festlv/uvfoto/README

Mechanical design files for UV photoresist exposer device.
It uses a modified laser-printer head with UV laser to expose photoresist on PCB's.
More details in latvian: http://hackerspace.lv/wiki/PCB_fotorezista_ekspon%C4%93%C5%A1ana_ar_l%C4%81zeru
