festlv/uvfoto/mechanical/assembly.SLDASM

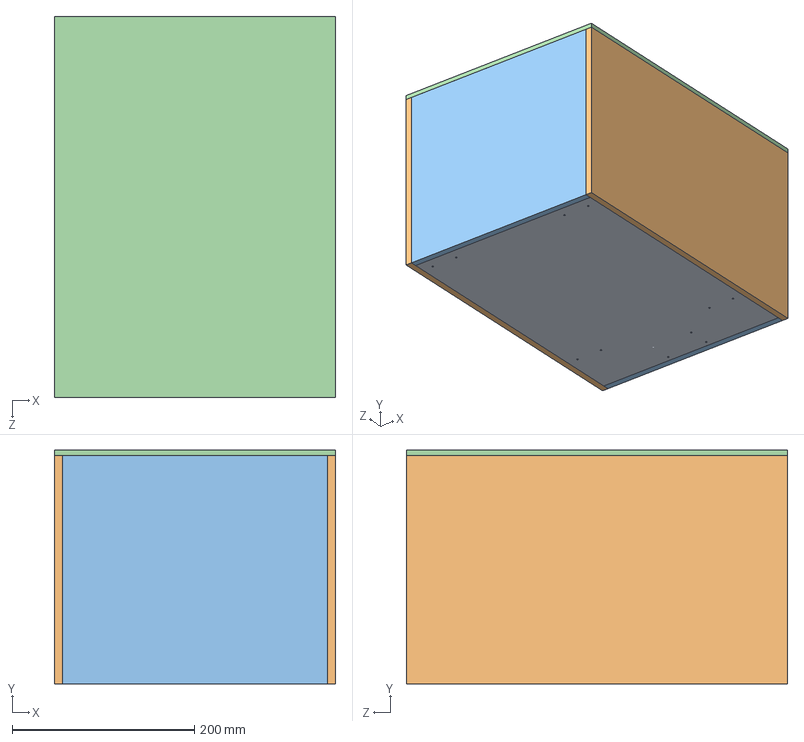
[picture p2: CAD file, 2013-05-30]
mechanical/assembly.SLDASM
308.0 x 256.0 x 418.0 mm
base
motor_mount
distancer x 4
nema_17_short
table
bar_mount x 3
bar x 2
bar_mount_switch
switch
pusher_bearing_mount x 2
lm8uul x 2
pusher_plank
pusher_mount
socket head cap screw_din x 4
slotted pan head screw_din x 11
prevailing torque nut style 1 insert_din x 4
toothed lock washer 1_din x 10
plain washer 6902 type abc_din x 9
hex nut gradec_din
carret
laserhead_base
mount
calibration x 2
mount_top
case_side x 2
case_back_side x 2
case_top
