festlv/uvfoto/mechanical/laserhead/head_assembly.SLDASM

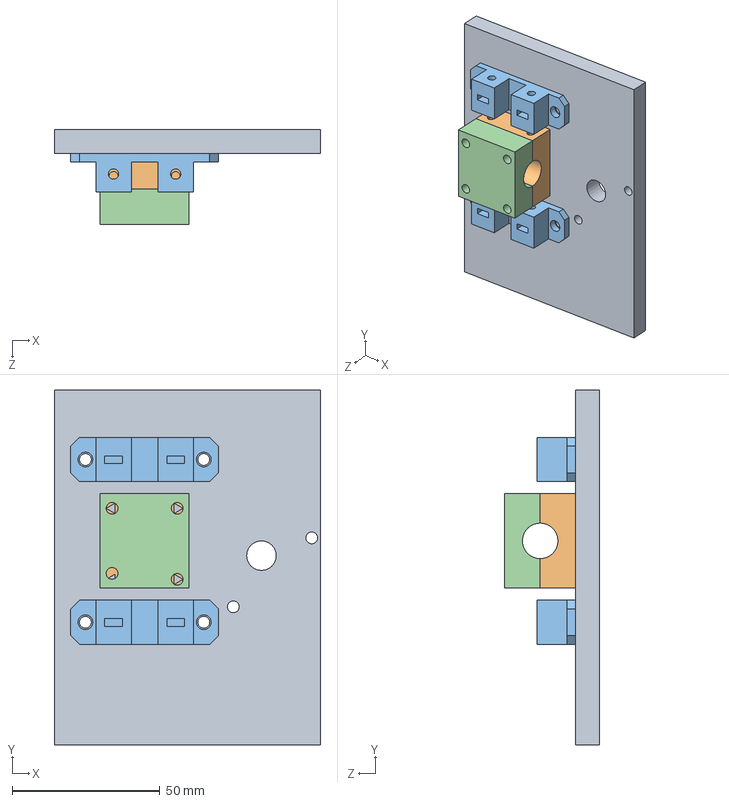
[picture p3: CAD file, 2013-05-30]
mechanical/laserhead/head_assembly.SLDASM
90.0 x 120.0 x 32.0 mm
laserhead_base
mount
calibration x 2
mount_top
