festlv/uvfoto/mechanical/bar_and_mounts.SLDASM

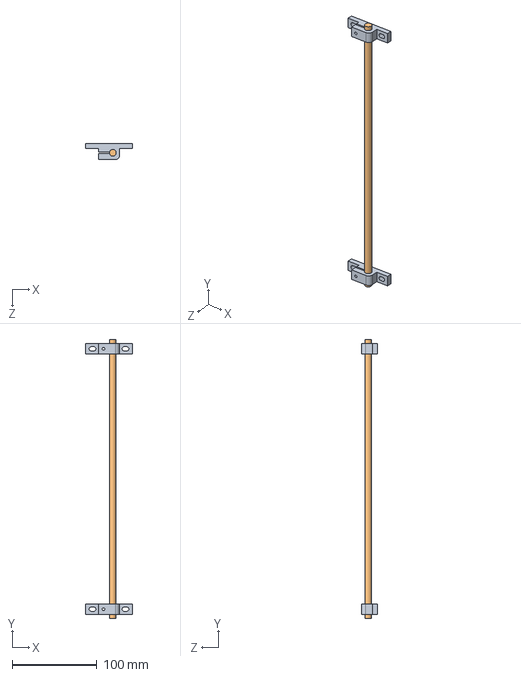
[picture p4: CAD file, 2013-04-28]
mechanical/bar_and_mounts.SLDASM
55.0 x 330.0 x 19.0 mm
bar_mount x 2
bar
