festlv/uvfoto/mechanical/bar_and_mounts_switch.SLDASM

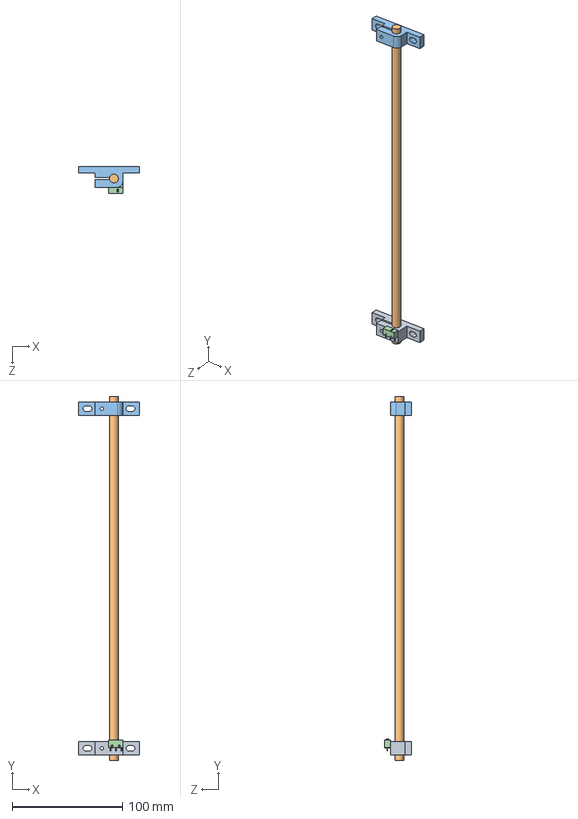
[picture p5: CAD file, 2013-04-28]
mechanical/bar_and_mounts_switch.SLDASM
55.0 x 330.0 x 24.7 mm
bar_mount_switch
bar
bar_mount
switch
