festlv/uvfoto/mechanical/motor_assy.SLDASM

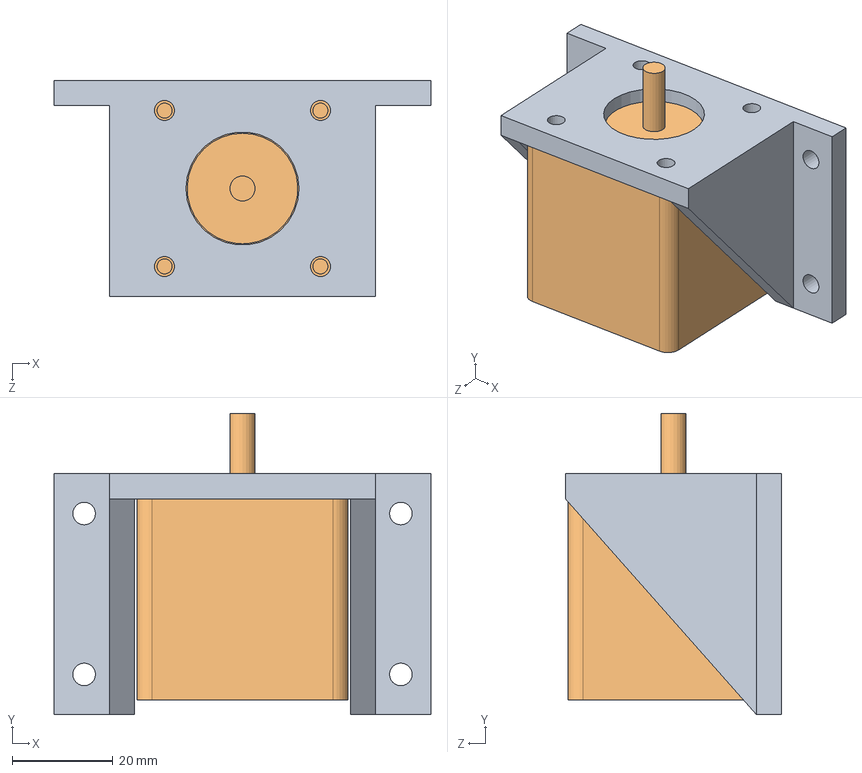
[picture p6: CAD file, 2013-03-12]
mechanical/motor_assy.SLDASM
75.0 x 59.9 x 43.0 mm
motor_mount
nema_17_short
