festlv/uvfoto/mechanical/case_top.SLDPRT

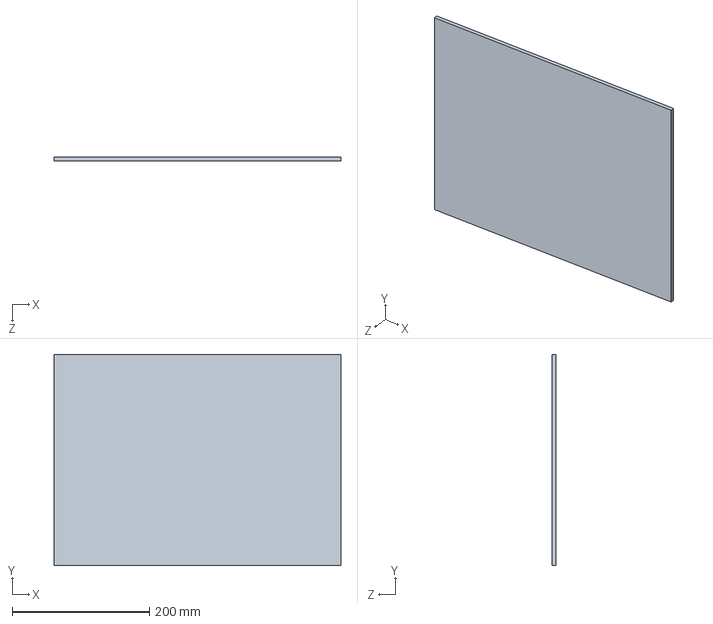
[picture p7: CAD file, 2013-05-30]
mechanical/case_top.SLDPRT
418.0 x 308.0 x 6.00 mm
