festlv/uvfoto/mechanical/laserhead/laserhead_base.SLDPRT

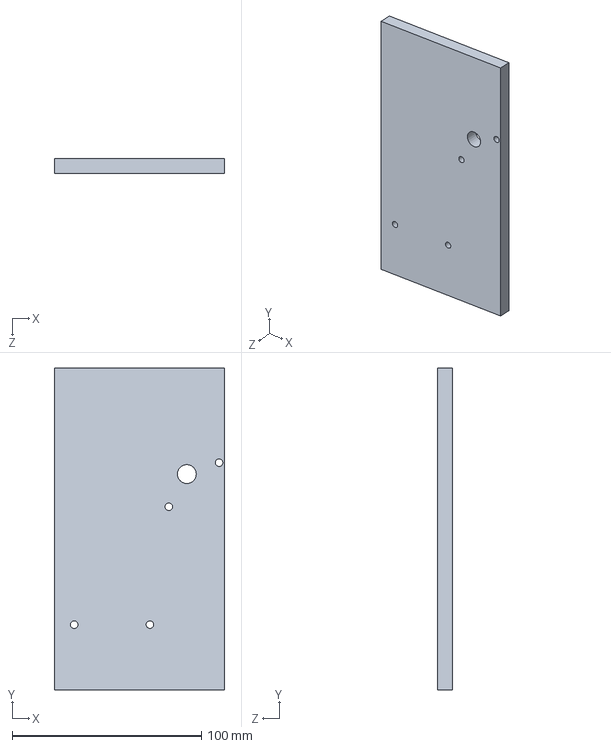
[picture p8: CAD file, 2013-05-30]
mechanical/laserhead/laserhead_base.SLDPRT
90.0 x 170.0 x 8.00 mm
