festlv/uvfoto/mechanical/stl/motor_coupling.stl

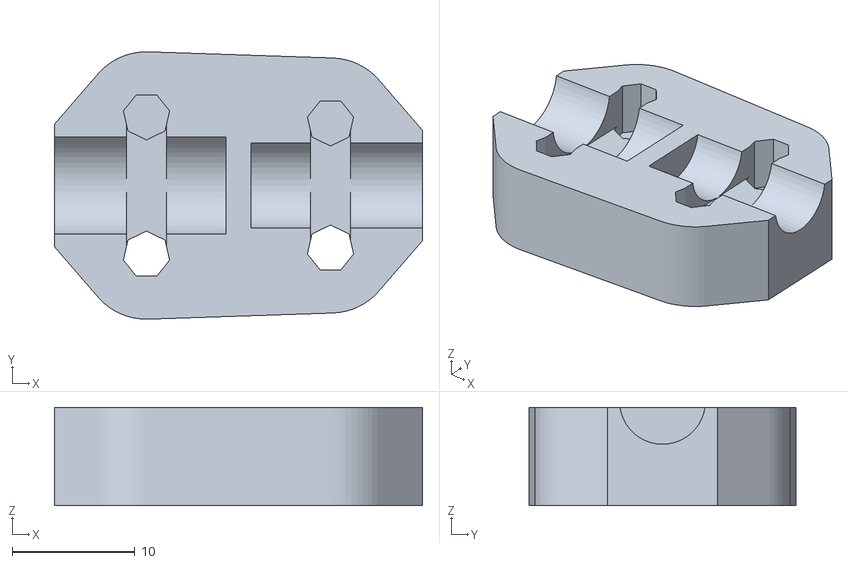
[picture p9: CAD file, 2013-04-28]
mechanical/stl/motor_coupling.stl
30.0 x 21.8 x 8.00
