festlv/uvfoto/mechanical/laserhead/mount.SLDPRT

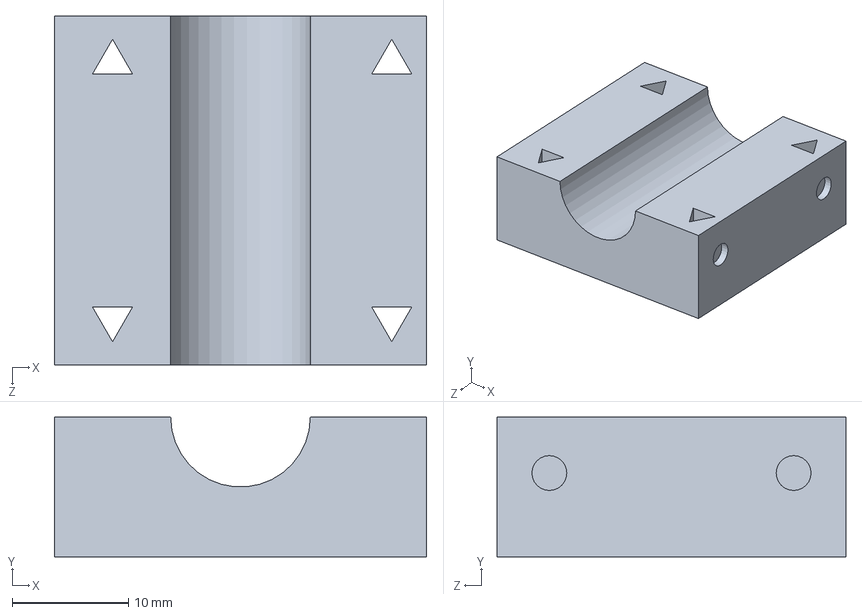
[picture p10: CAD file, 2013-05-30]
mechanical/laserhead/mount.SLDPRT
32.0 x 12.0 x 30.0 mm
