festlv/uvfoto/mechanical/stl/plate.stl

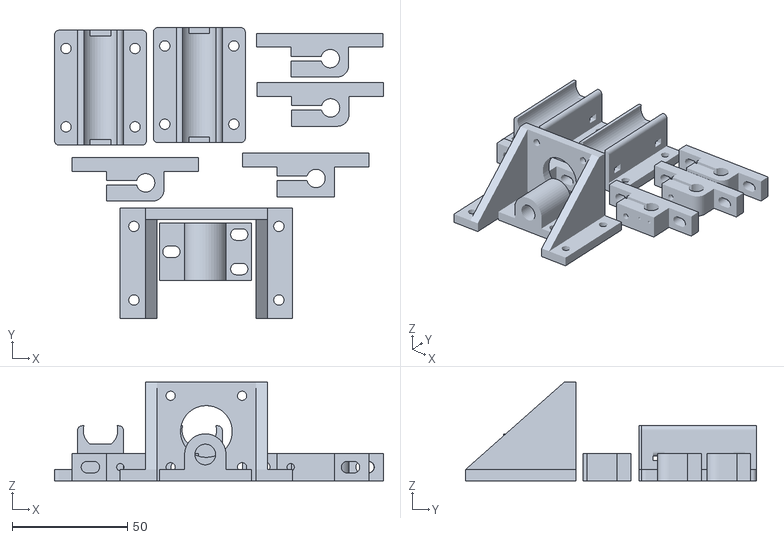
[picture p11: CAD file, 2013-04-28]
mechanical/stl/plate.stl
143.0 x 126.4 x 43.0
