festlv/uvfoto/mechanical/case_side.SLDPRT

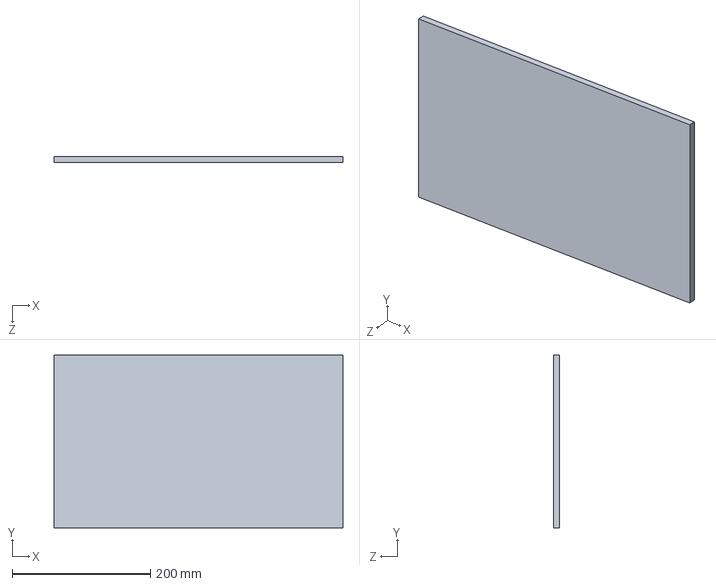
[picture p12: CAD file, 2013-05-30]
mechanical/case_side.SLDPRT
418.0 x 250.0 x 9.00 mm
