festlv/uvfoto/mechanical/laserhead/calibration.SLDPRT

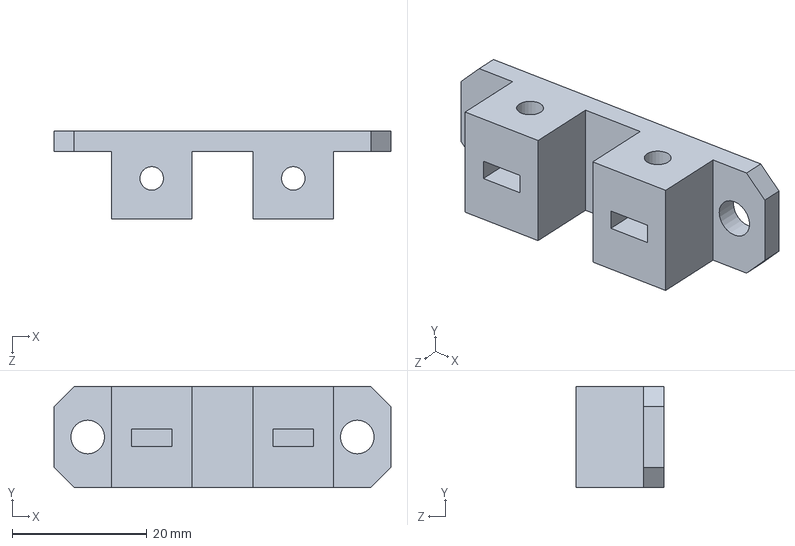
[picture p13: CAD file, 2013-05-30]
mechanical/laserhead/calibration.SLDPRT
50.0 x 15.0 x 13.0 mm
