festlv/uvfoto/mechanical/case_back_side.SLDPRT

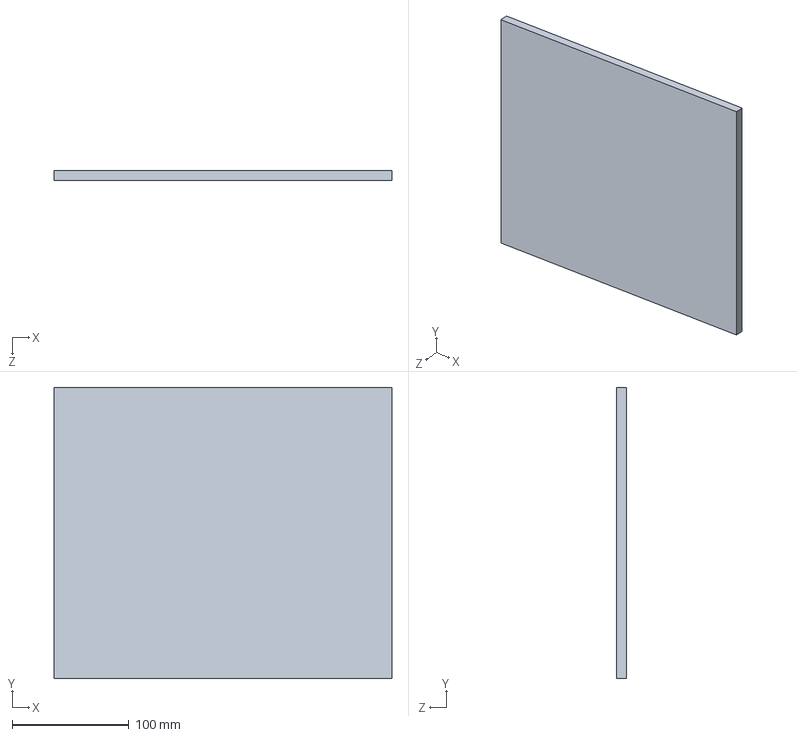
[picture p14: CAD file, 2013-05-30]
mechanical/case_back_side.SLDPRT
290.0 x 250.0 x 9.00 mm
