festlv/uvfoto/mechanical/bar_mount.SLDPRT

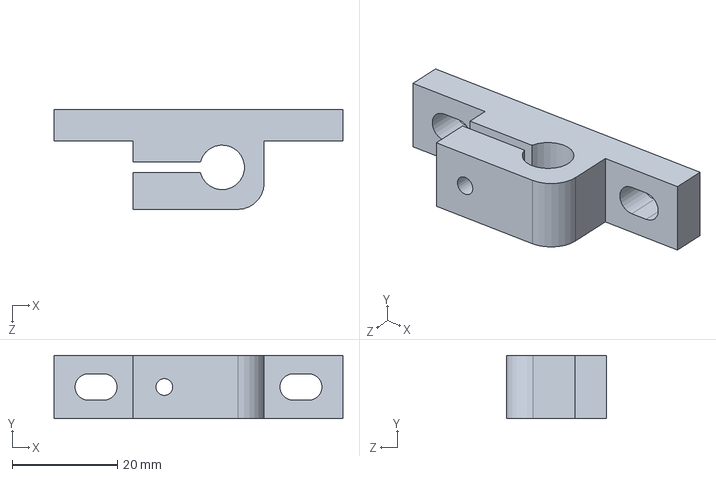
[picture p15: CAD file, 2013-04-28]
mechanical/bar_mount.SLDPRT
55.0 x 12.0 x 19.0 mm
