festlv/uvfoto/mechanical/pusher_bearing_mount.SLDPRT

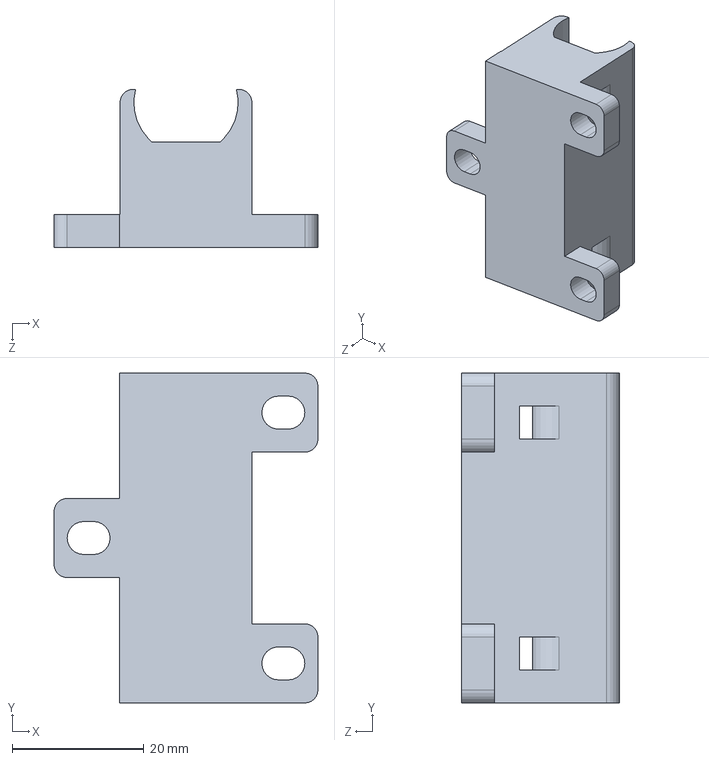
[picture p16: CAD file, 2013-04-28]
mechanical/pusher_bearing_mount.SLDPRT
40.0 x 50.0 x 24.0 mm
