festlv/uvfoto/mechanical/motor_mount.SLDPRT

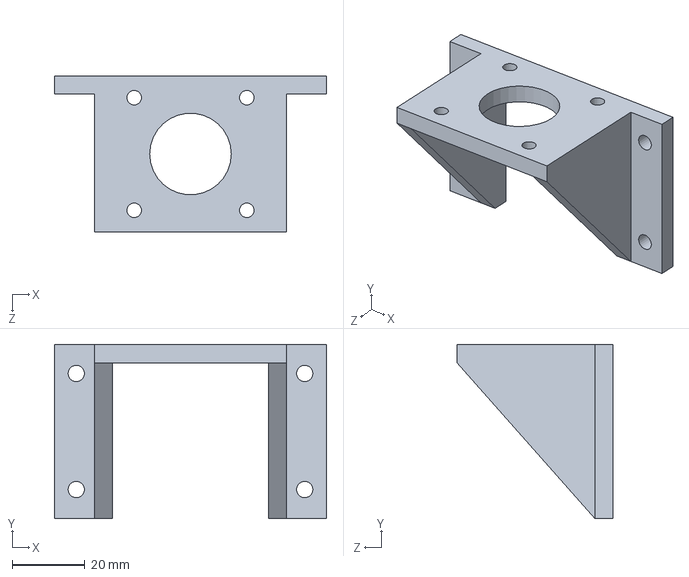
[picture p17: CAD file, 2013-04-28]
mechanical/motor_mount.SLDPRT
75.0 x 48.0 x 43.0 mm
