festlv/uvfoto/mechanical/pusher_plank.SLDPRT

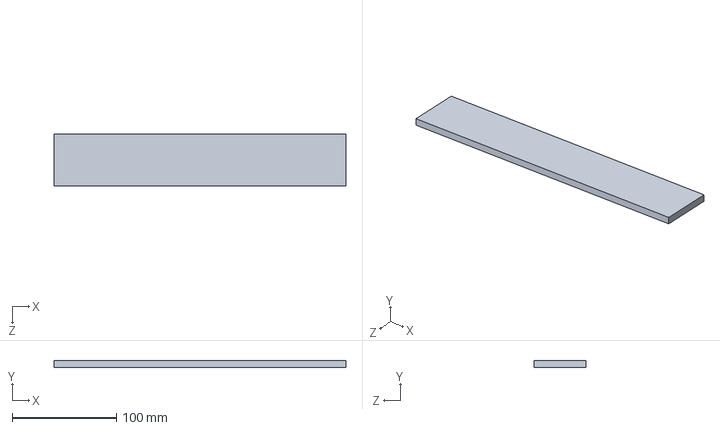
[picture p18: CAD file, 2013-04-28]
mechanical/pusher_plank.SLDPRT
280.0 x 6.50 x 50.0 mm
