festlv/uvfoto/mechanical/carret_support.SLDPRT

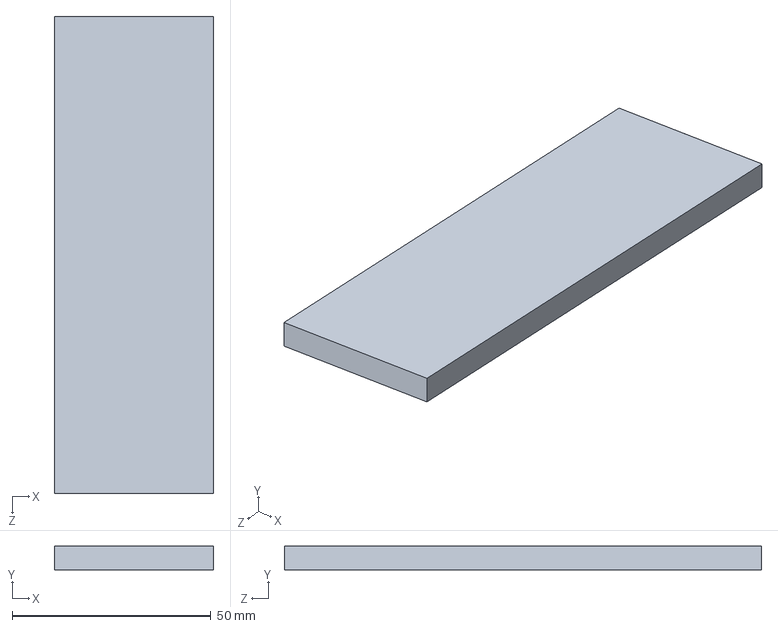
[picture p19: CAD file, 2013-03-12]
mechanical/carret_support.SLDPRT
40.0 x 6.00 x 120.0 mm
