festlv/uvfoto/mechanical/pusher_mount.SLDPRT

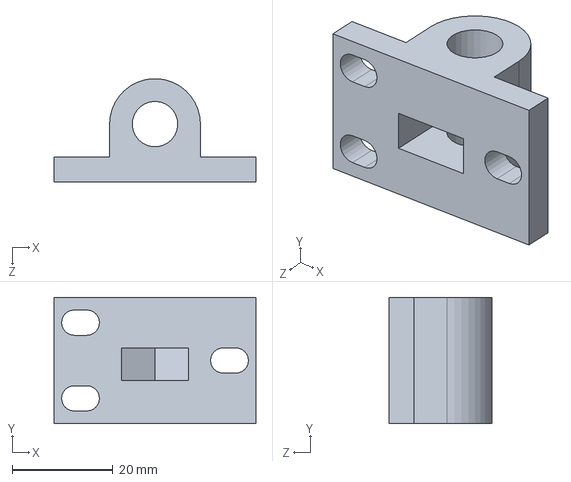
[picture p20: CAD file, 2013-03-12]
mechanical/pusher_mount.SLDPRT
40.0 x 25.0 x 20.5 mm
