festlv/uvfoto/mechanical/base.SLDPRT

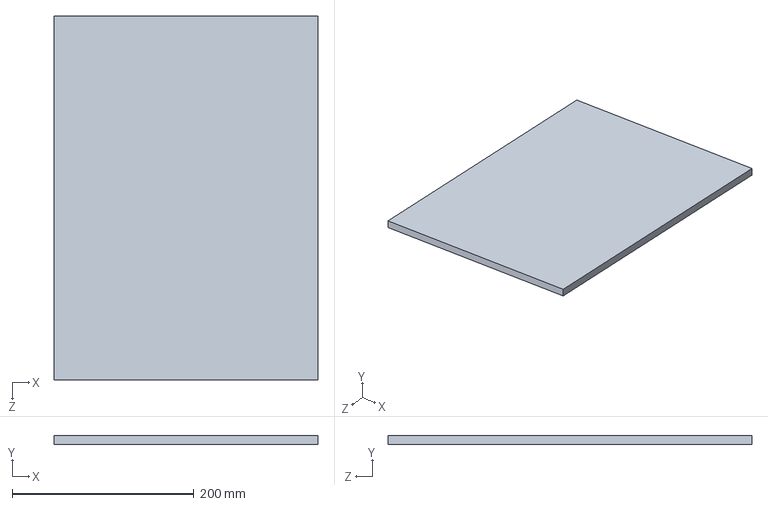
[picture p21: CAD file, 2013-03-12]
mechanical/base.SLDPRT
290.0 x 10.0 x 400.0 mm
