festlv/uvfoto/mechanical/carret.SLDPRT

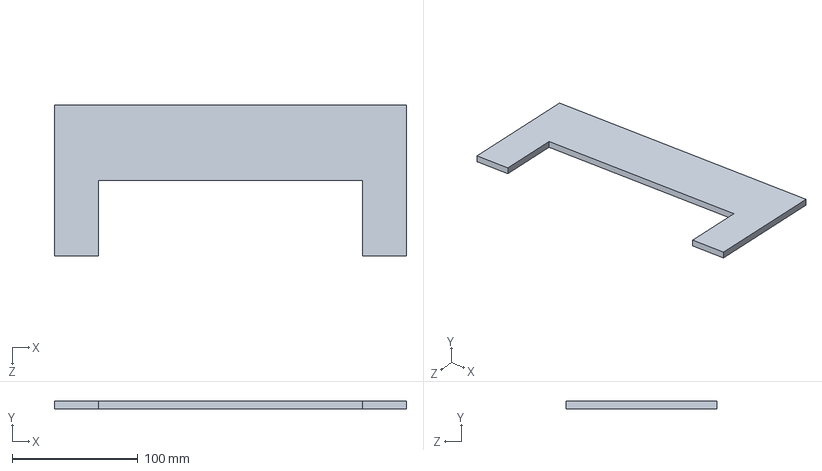
[picture p22: CAD file, 2013-03-12]
mechanical/carret.SLDPRT
280.0 x 6.00 x 120.0 mm
