festlv/uvfoto/mechanical/table.SLDPRT

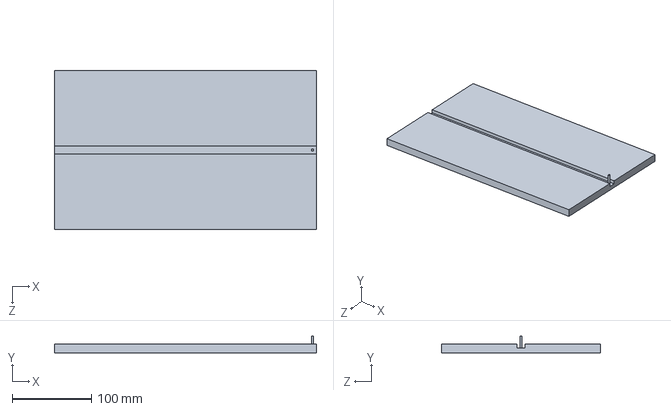
[picture p23: CAD file, 2013-03-12]
mechanical/table.SLDPRT
330.0 x 21.0 x 200.0 mm
