festlv/uvfoto/mechanical/lm8uul.SLDPRT

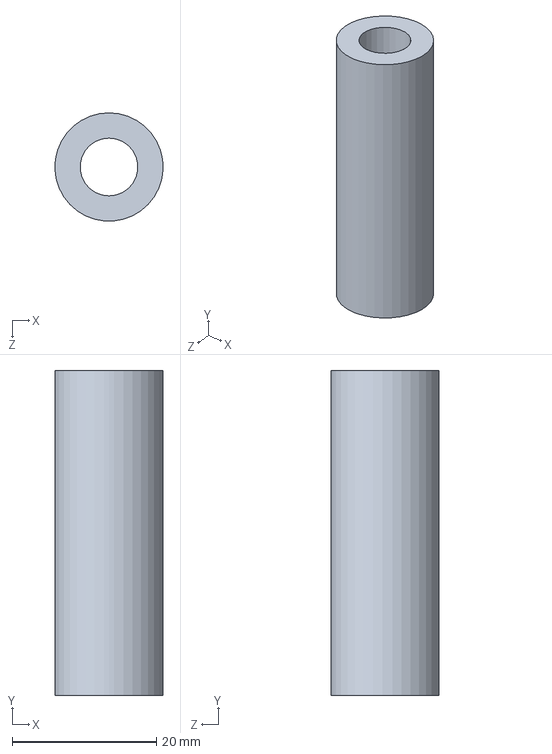
[picture p24: CAD file, 2013-02-02]
mechanical/lm8uul.SLDPRT
15.0 x 45.0 x 15.0 mm
