festlv/uvfoto/mechanical/bar.SLDPRT

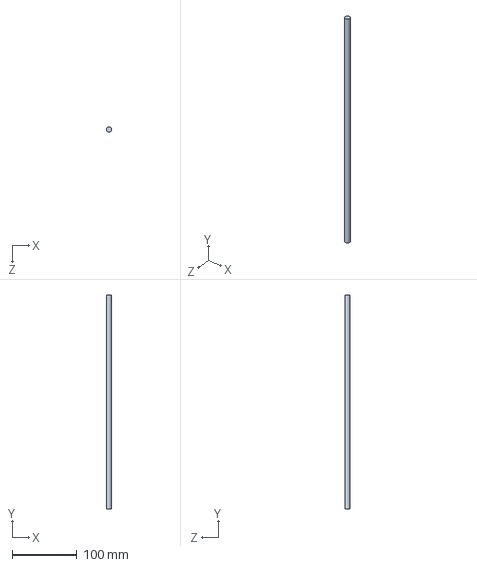
[picture p25: CAD file, 2013-02-02]
mechanical/bar.SLDPRT
8.00 x 330.0 x 8.00 mm
