festlv/uvfoto/mechanical/switch.SLDPRT

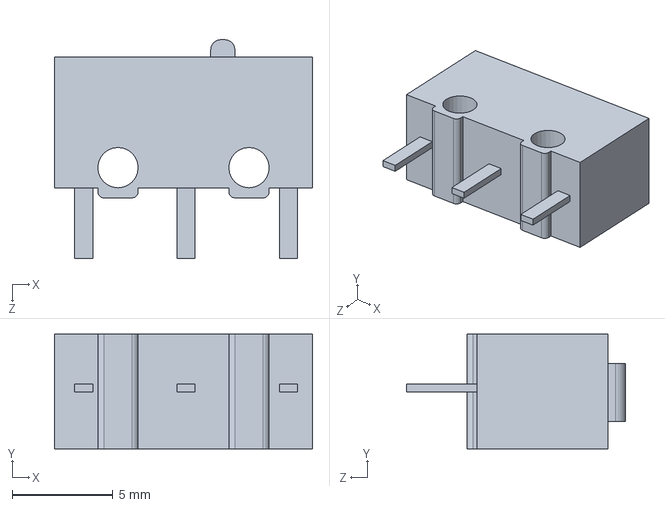
[picture p26: CAD file, 2013-02-02]
mechanical/switch.SLDPRT
12.8 x 5.70 x 10.9 mm
