festlv/uvfoto/mechanical/distancer.SLDPRT

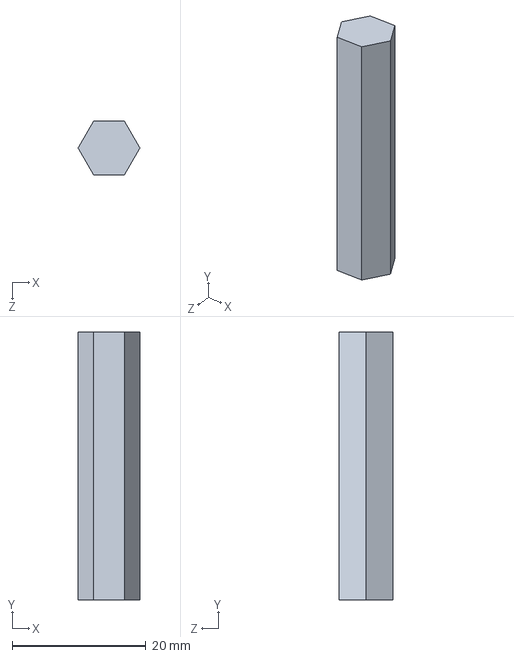
[picture p27: CAD file, 2013-02-02]
mechanical/distancer.SLDPRT
9.24 x 40.0 x 8.00 mm
