festlv/uvfoto/mechanical/bar_pusher.SLDPRT

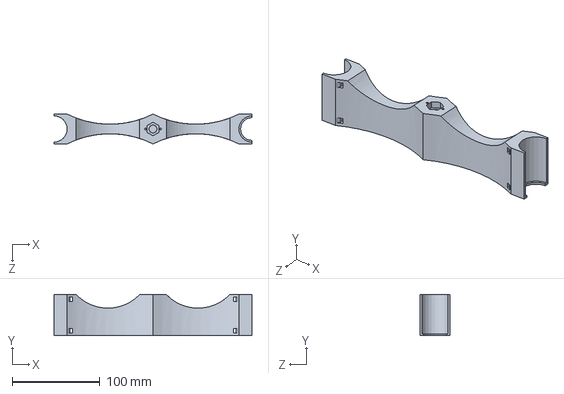
[picture p28: CAD file, 2013-01-31]
mechanical/bar_pusher.SLDPRT
226.0 x 47.0 x 34.0 mm
