festlv/uvfoto/mechanical/nema_17_short.SLDPRT

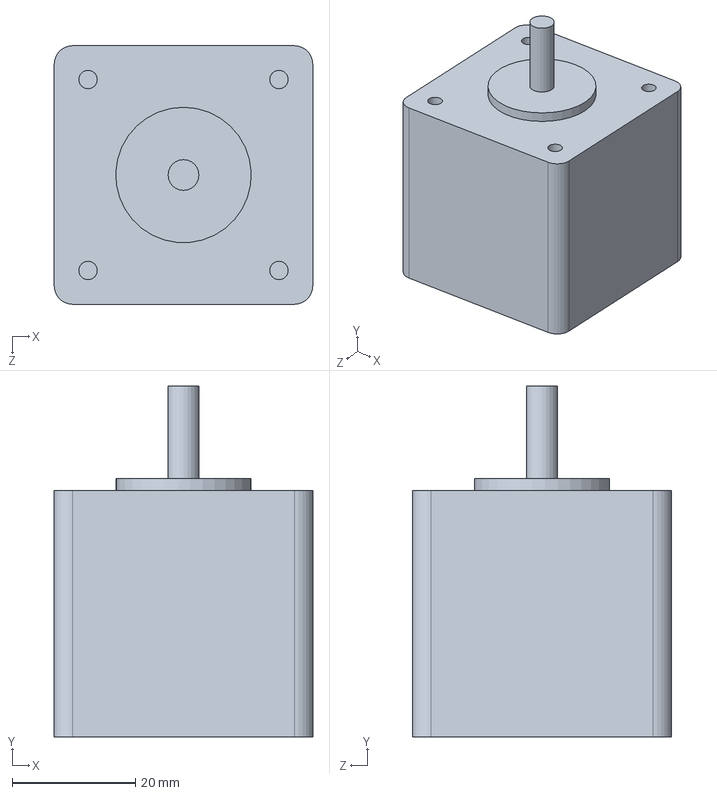
[picture p29: CAD file, 2013-01-31]
mechanical/nema_17_short.SLDPRT
42.0 x 57.0 x 42.0 mm
