festlv/uvfoto/(list of files, cad)

Other CAD files:
mechanical/Assem1.sldasm
mechanical/laserhead/mount_top.SLDPRT
mechanical/bar_mount_switch.SLDPRT
mechanical/fixing_block.SLDPRT
mechanical/Part1.sldprt
mechanical/drafts/assembly.SLDDRW
mechanical/drafts/base.SLDDRW
mechanical/drafts/case_back_side.SLDDRW
mechanical/drafts/case_side.SLDDRW
mechanical/fasteners/cross_dowel.SLDPRT
mechanical/fasteners/hex_head_screw.SLDPRT
mechanical/fasteners/m4x25.SLDPRT
mechanical/fasteners/m4x30.SLDPRT
mechanical/fixing_block.stl
mechanical/stl/bar_mount.stl
mechanical/stl/bar_mount_switch.SLDPRT
mechanical/stl/bar_mount_switch.stl
mechanical/stl/motor_mount.stl
mechanical/stl/pusher_bearing_mount.stl
mechanical/stl/pusher_mount.stl
