festlv/uvfoto/linux-software/test-pcb/sla-F_Cu.png

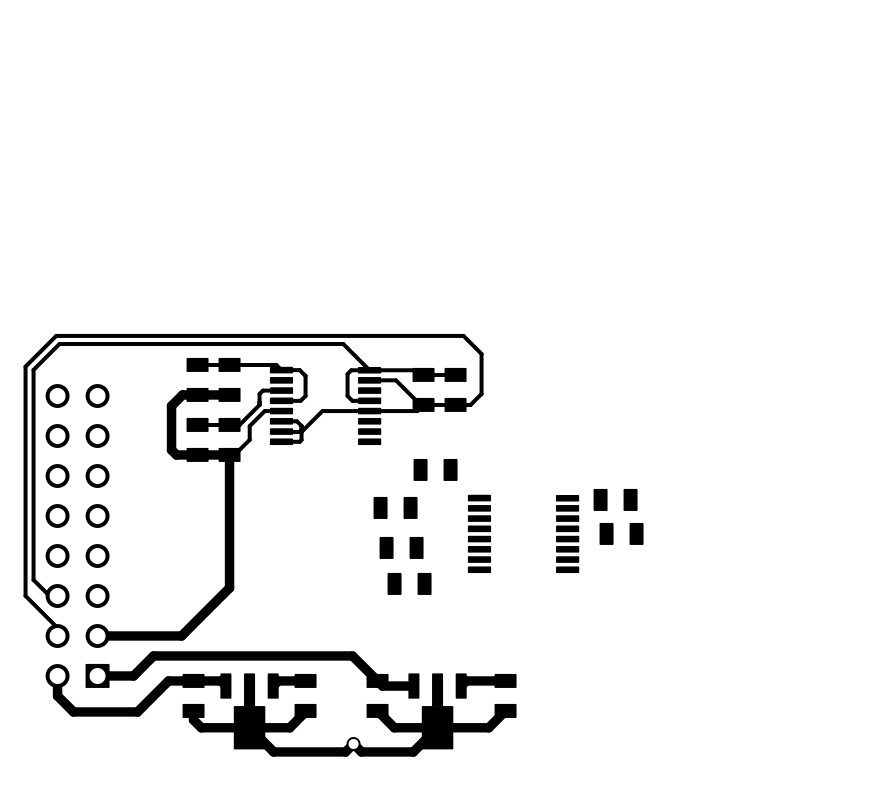
linux-software/test-pcb/sla-F_Cu.png
