festlv/uvfoto/py_image/test.png

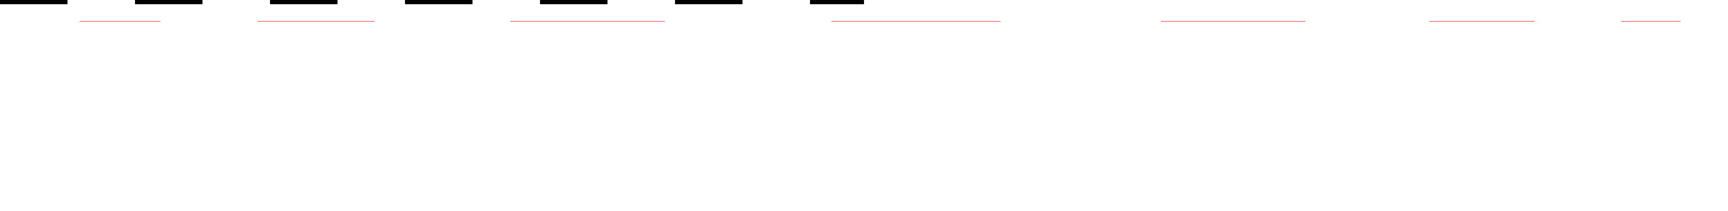
py_image/test.png
