festlv/uvfoto/schematics/kicad/laser_peripherals.pdf

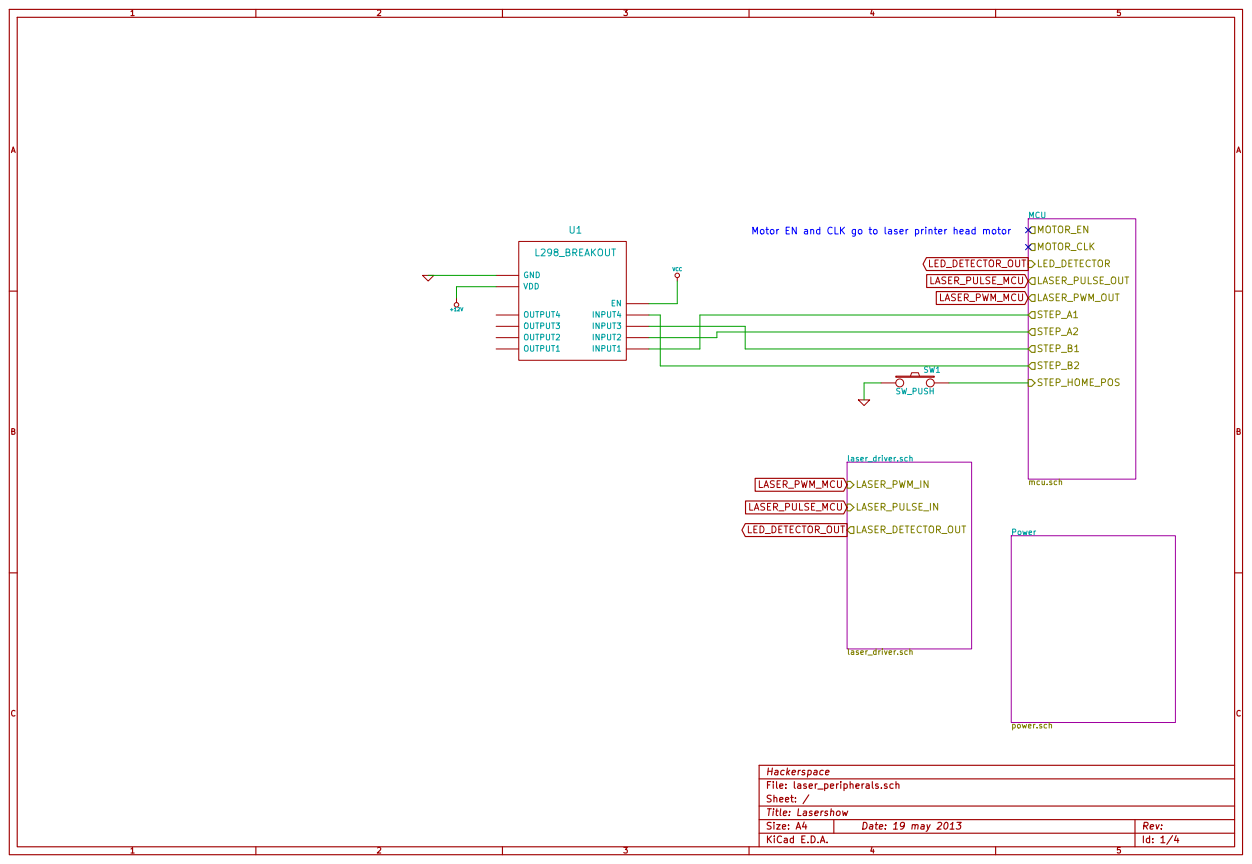
[picture p32: page 1]

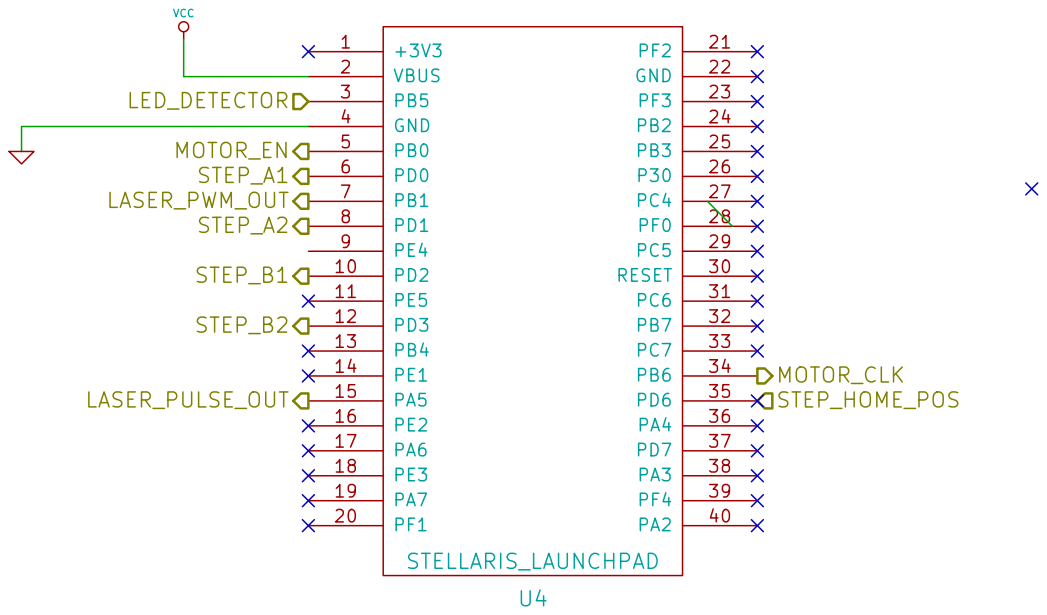
[picture p33: page 2]

Hackerspace
File: mcu.sch Sheet: /MCU/

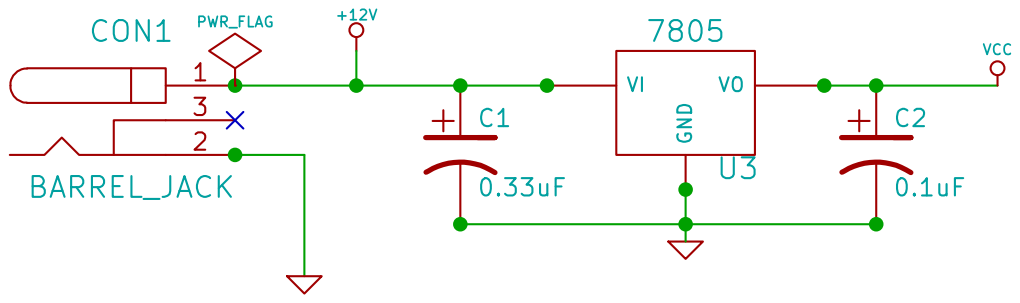
[picture p34: page 3]

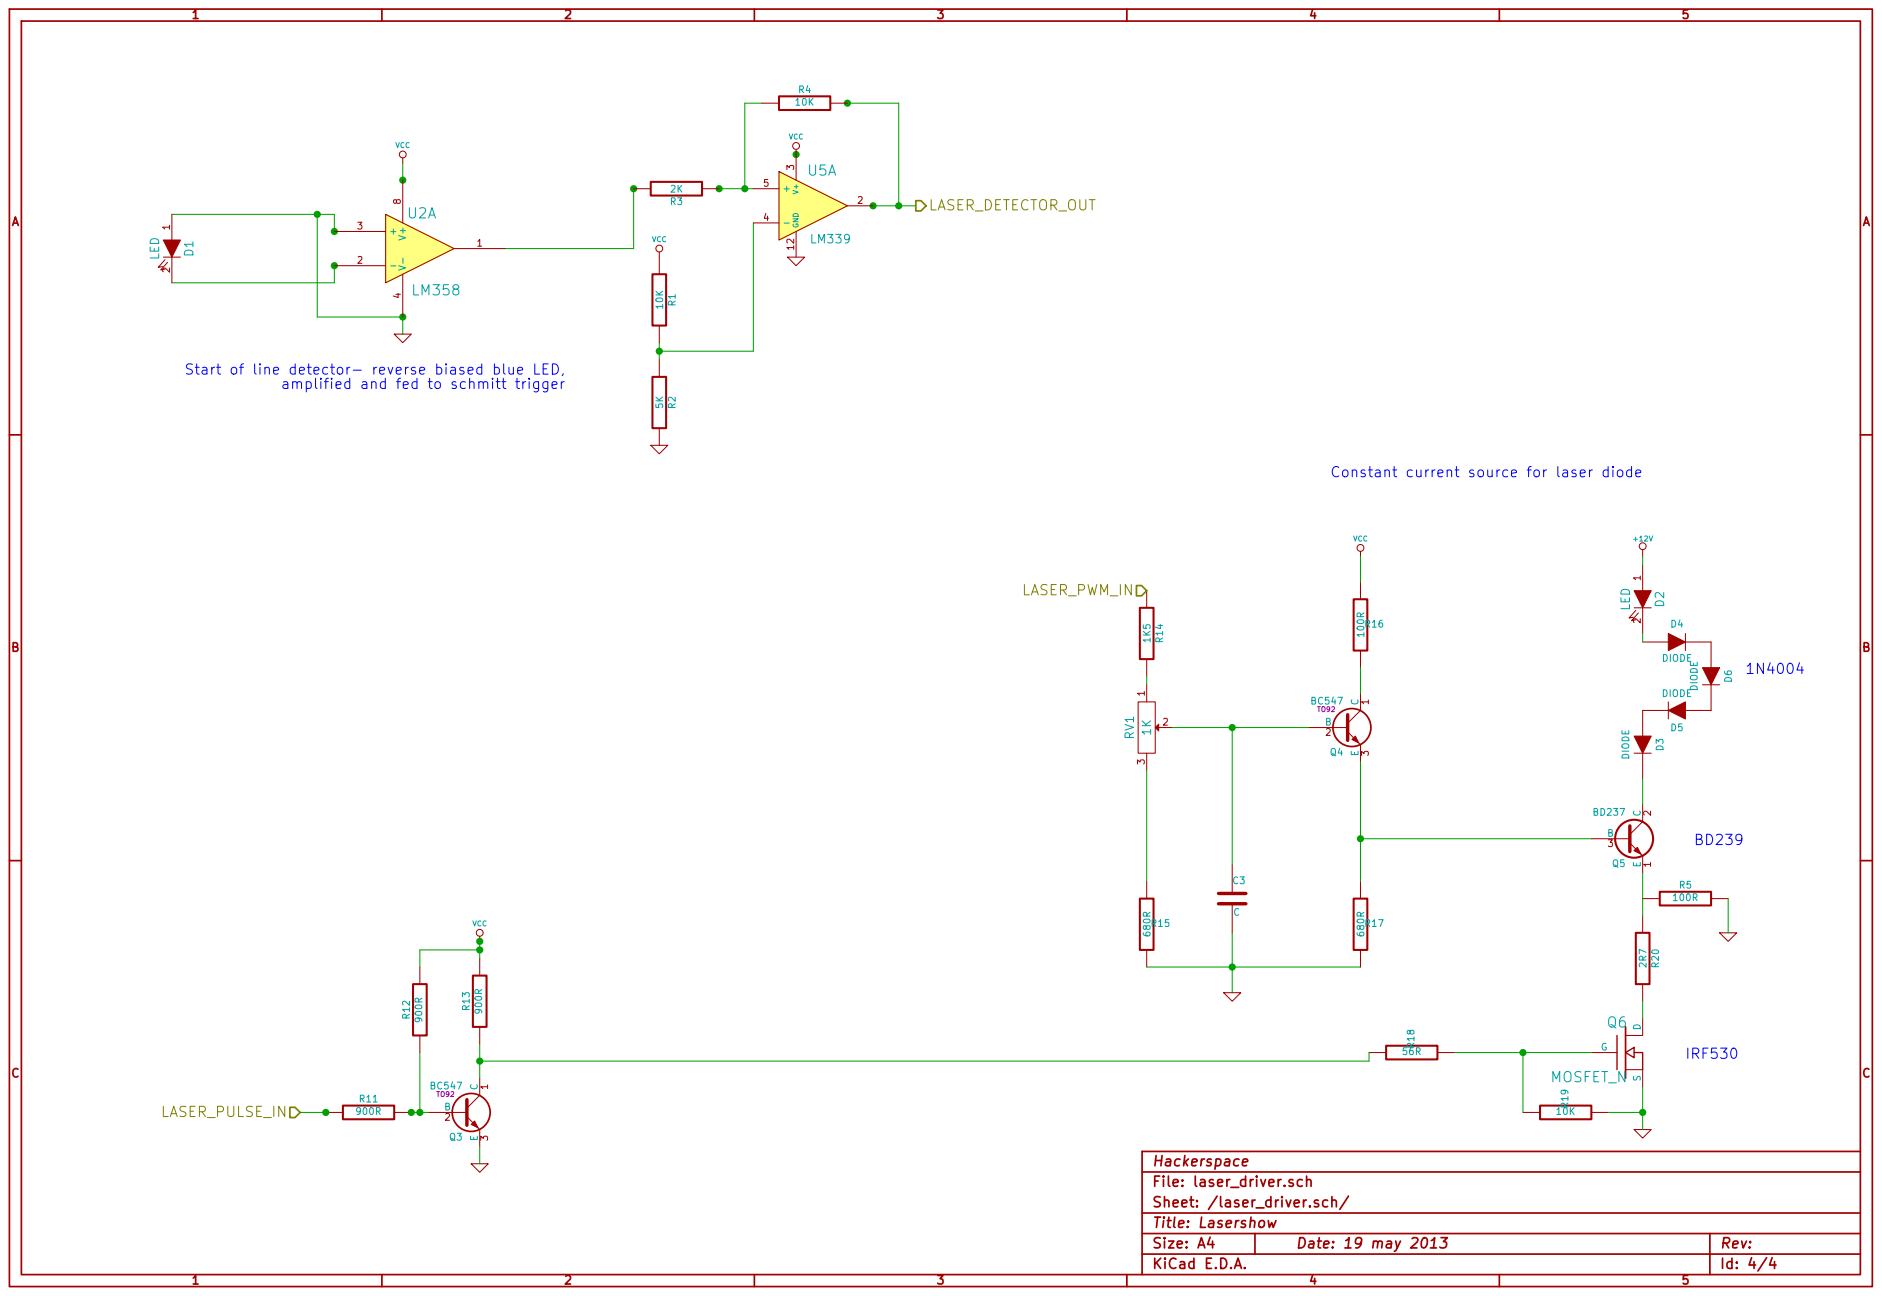
[picture p35: page 4]

Start of line detector- reverse biased blue LED,

Constant current source for laser diode
Hackerspace 1K5 R14 R15 680R
