festlv/uvfoto/mechanical/drafts/case_back_side.PDF

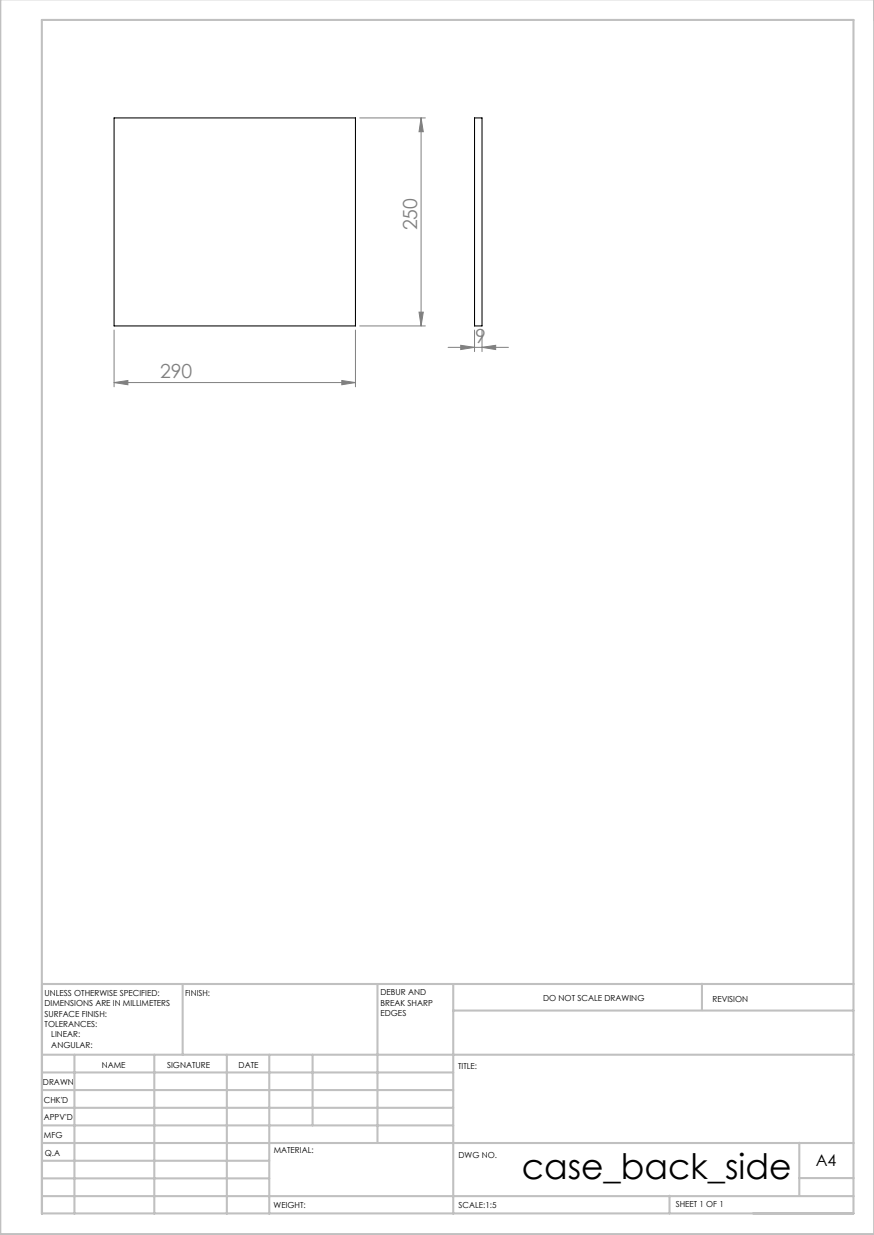
[picture p36: page 1]
SCALE:1:5; SHEET 1 OF 1; DO NOT SCALE DRAWING; REVISION; DEBUR AND BREAK SHARP; UNLESS OTHERWISE SPECIFIED:; FINISH:

DIMENSIONS ARE IN MILLIMETERS
SURFACE FINISH:
TOLERANCES:
LINEAR:
ANGULAR:

NAME | SIGNATURE | DATE | | | | TITLE:
Q.A | | | | MATERIAL: | case_back_side WEIGHT: DWG NO. | A4

DRAWN
CHK'D
APPV'D
MFG
