festlv/uvfoto/schematics/kicad/laser_driver.sch

## KiCad design schematics/kicad/laser_driver.sch (2013-06-02)

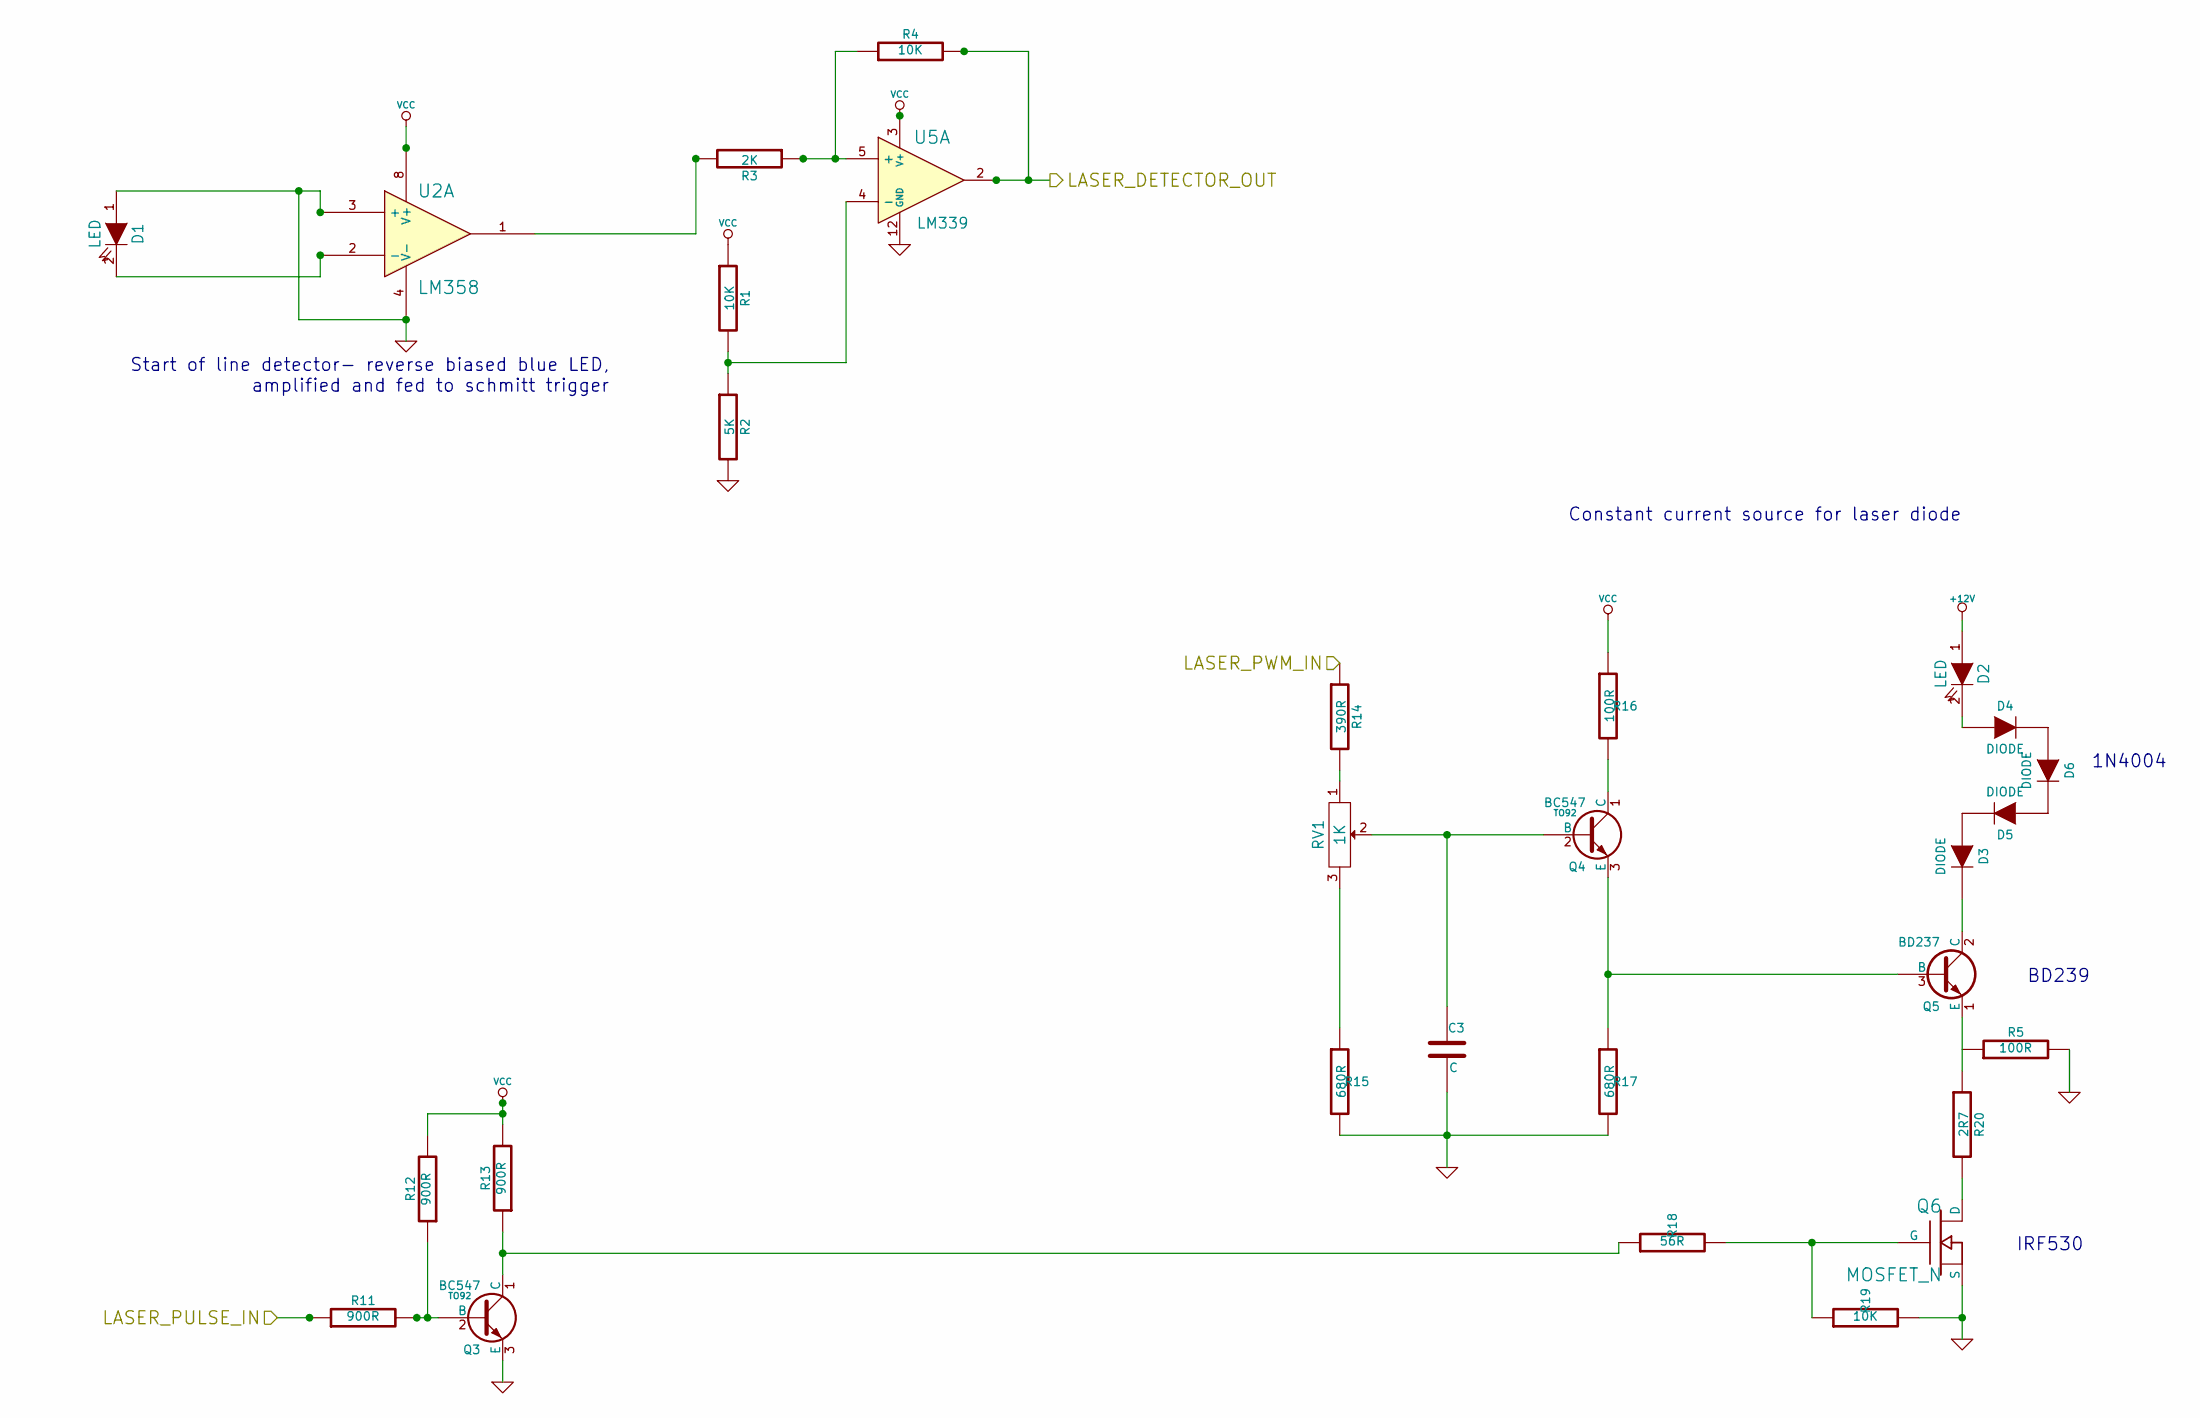
[picture p37: schematic laser_driver.sch]

Parts:
C3: C
D1, D2: LED
D3, D4, D5, D6: DIODE
Q3, Q4: BC547; TO92
Q5: BD237; TO126
Q6: MOSFET_N
R1, R4, R19: 10K
R2: 5K
R3: 2K
R5, R16: 100R
R11, R12, R13: 900R
R14: 390R
R15, R17: 680R
R18: 56R
R20: 2R7
RV1: 1K
U2: LM358
U5: LM339

Connections:
+12V: D2.1 (A)
GND: C3.2, D1.1 (A), Q3.3 (E), Q6.S, R2.2, R5.2, R15.2, R17.2, R19.2, U2.3 (+), U2.4 (V-), U5.12 (GND)
LASER_DETECTOR_OUT: R4.2, U5.2
LASER_PULSE_IN: R11.1
LASER_PWM_IN: R14.1
unnamed: C3.1, Q4.2 (B), RV1.2
unnamed: D1.2 (K), U2.2 (-)
unnamed: D2.2 (K), D4.1 (A)
unnamed: D3.1 (A), D5.2 (K)
unnamed: D3.2 (K), Q5.2 (C)
unnamed: D4.2 (K), D6.1 (A)
unnamed: D5.1 (A), D6.2 (K)
unnamed: Q3.1 (C), R13.1, R18.1
unnamed: Q3.2 (B), R11.2, R12.1
unnamed: Q4.1 (C), R16.2
unnamed: Q4.3 (E), Q5.3 (B), R17.1
unnamed: Q5.1 (E), R20.1
unnamed: Q6.D, R20.2
unnamed: Q6.G, R18.2, R19.1
unnamed: R1.2, R2.1, U5.4 (-)
unnamed: R3.1, R4.1, U5.5 (+)
unnamed: R3.2, U2.1
unnamed: R14.2, RV1.1
unnamed: R15.1, RV1.3
VCC: R1.1, R12.2, R13.2, R16.1, U2.8 (V+), U5.3 (V+)

Notes on the sheet:
BD239
IRF530
1N4004
Constant current source for laser diode
Start of line detector- reverse biased blue LED, amplified and fed to schmitt trigger
