festlv/uvfoto/schematics/kicad/laser_peripherals.sch

## KiCad design schematics/kicad/laser_peripherals.sch (2013-06-02)

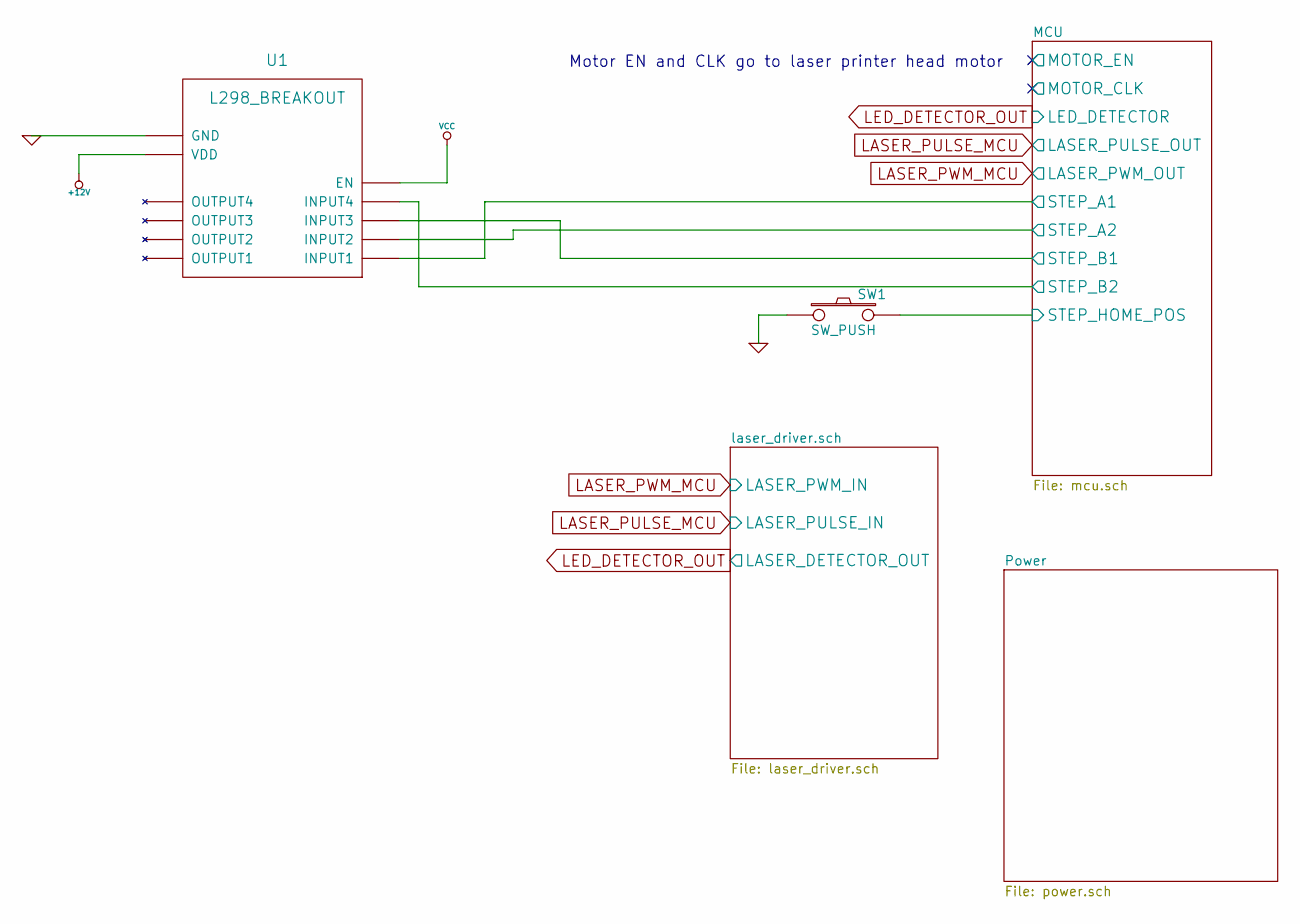
[picture p38: schematic laser_peripherals.sch]

Parts:
SW1: SW_PUSH
U1: L298_BREAKOUT

Connections:
+12V: U1.10 (VDD)
GND: SW1.1, U1.11 (GND)
STEP_A1: U1.1 (INPUT1)
STEP_A2: U1.2 (INPUT2)
STEP_B1: U1.3 (INPUT3)
STEP_B2: U1.4 (INPUT4)
STEP_HOME_POS: SW1.2
VCC: U1.5 (EN)

Notes on the sheet:
Motor EN and CLK go to laser printer head motor
