festlv/uvfoto/schematics/kicad/power.sch

## KiCad design schematics/kicad/power.sch (2013-06-02)

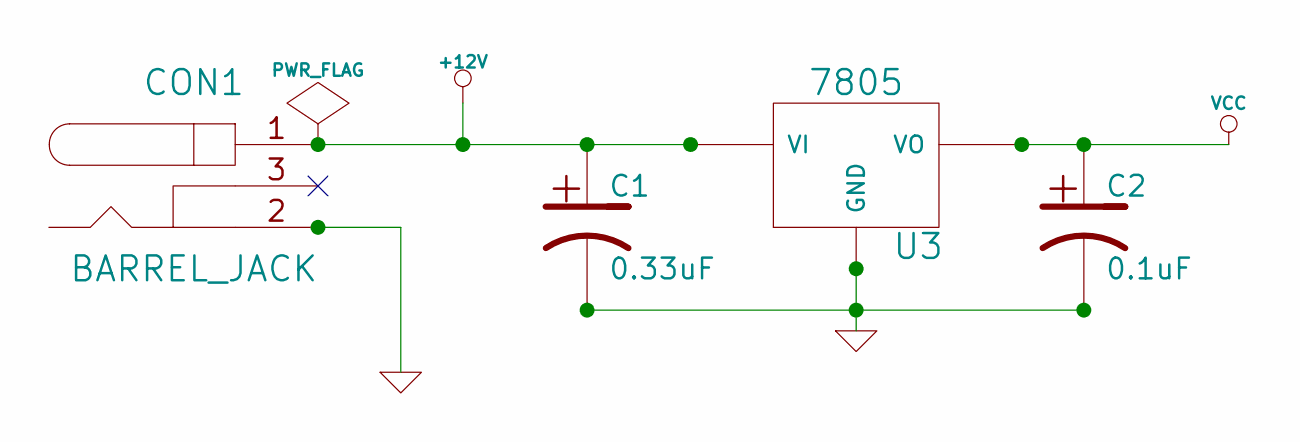
[picture p39: schematic power.sch]

Parts:
C1: 0.33uF
C2: 0.1uF
CON1: BARREL_JACK
U3: 7805

Connections:
+12V: C1.1, CON1.1, U3.VI
GND: C1.2, C2.2, CON1.2, U3.GND
VCC: C2.1, U3.VO
