festlv/uvfoto/launchpad-firmware/src/laser.c

#include "laser.h"
#include "laser_intensity.h"

#include <math.h>
#include <stdio.h>

#include "inc/hw_ints.h"
#include "inc/hw_gpio.h"
#include "inc/hw_memmap.h"
#include "inc/hw_sysctl.h"
#include "inc/hw_types.h"
#include "driverlib/gpio.h"
#include "driverlib/pin_map.h"
#include "driverlib/sysctl.h"
#include "driverlib/interrupt.h"
#include "driverlib/timer.h"


#include "systick.h"

uint8_t ssi_data[LASER_DATA_LENGTH];


//store last NUM_AVERAGE_TIME times between start of line interrupts
#define NUM_AVERAGE_TIME 10

volatile unsigned int timer_values[NUM_AVERAGE_TIME];

static volatile uint8_t laser_enabled = 0;
static volatile uint8_t laser_intensity=255;
static volatile uint16_t laser_exposure_time=1000;

static volatile uint16_t laser_ms_per_rotation=0;

//when laser is enabled, it is active for up to laser_num_rotations
static volatile uint16_t laser_max_enabled_rotations;
static volatile uint16_t laser_current_rotations;

volatile unsigned int edge_count=0;

static void start_of_line_handler();

void laser_load_data(uint8_t * data, uint16_t length) {
    uint16_t read_length;

    read_length = length > LASER_DATA_LENGTH ? LASER_DATA_LENGTH : length;
    uint16_t i;
    for (i=0;i<read_length;i++)
        ssi_data[i] = data[i];
    if (i != (LASER_DATA_LENGTH -1)) {
        for (int j=i+1;j < LASER_DATA_LENGTH; j++)
            ssi_data[j] = 0xff;
    }
}

static void init_start_of_line_interrupt() {
    //start of line interrupt on PB5
    SysCtlPeripheralEnable(SYSCTL_PERIPH_GPIOB);
    GPIOPinTypeGPIOInput(GPIO_PORTB_BASE, GPIO_PIN_5);
    GPIOIntRegister(GPIO_PORTB_BASE, start_of_line_handler);
    GPIOIntTypeSet(GPIO_PORTB_BASE, GPIO_PIN_5, GPIO_RISING_EDGE);
    GPIOIntEnable(GPIO_PORTB_BASE, GPIO_INT_PIN_5);
}


void laser_step() {
    if (systick_get_count() % SYSTICK_FREQ ==0) {
        edge_count=0;
    }
}

static void laser_write_bit() {
    static volatile uint16_t data_index = 0;
    static volatile uint8_t bit_mask = 1;
    TimerIntClear(TIMER3_BASE, TIMER_TIMA_TIMEOUT);

    if (ssi_data[data_index] & bit_mask) {
        GPIOPinWrite(GPIO_PORTA_BASE, GPIO_PIN_5, 0x00);    
    } else {
        GPIOPinWrite(GPIO_PORTA_BASE, GPIO_PIN_5, 0xff);
    }

    bit_mask = bit_mask << 1;
    if (bit_mask == 0) {
        bit_mask = 1;
        data_index++;
        if (data_index >= (LASER_DATA_LENGTH - 100)) {
            TimerDisable(TIMER3_BASE, TIMER_A);
            GPIOPinWrite(GPIO_PORTA_BASE, GPIO_PIN_5, 0xff);
            data_index=0;
        }
    }
}

static void laser_init_timers() {
    //timer is used to filter out false rising edges in interrupt handler
	SysCtlPeripheralEnable(SYSCTL_PERIPH_TIMER3);
	TimerConfigure(TIMER3_BASE, TIMER_CFG_SPLIT_PAIR | 
            TIMER_CFG_A_PERIODIC | TIMER_CFG_B_PERIODIC);

    //prescaler 80, yields 1mhz timer clock
    TimerPrescaleSet(TIMER3_BASE, TIMER_B, 80);
    TimerPrescaleSet(TIMER3_BASE, TIMER_A, 0);
    
	TimerLoadSet(TIMER3_BASE, TIMER_B, 60000);
	TimerEnable(TIMER3_BASE, TIMER_B);

    TimerIntRegister(TIMER3_BASE, TIMER_A, laser_write_bit);
    TimerIntEnable(TIMER3_BASE, TIMER_TIMA_TIMEOUT);  
}

static void laser_setup_bit_timer(int rotation_period) {
    //calculate delay between bits according to rotation period
    float period_in_s = rotation_period / 1000000.0;
    float time_per_bit = period_in_s / (LASER_DATA_LENGTH*8);
    uint8_t timer_value = (uint8_t)(time_per_bit * SysCtlClockGet());
    printf("Timer value: %d\n", timer_value);
    TimerLoadSet(TIMER3_BASE, TIMER_A, timer_value);


    //save ms per rotation, so we can use number of rotation cycles to 
    //calculate how long have we been exposing the plate
    laser_ms_per_rotation = rotation_period / 1000;
}

void laser_init() {
    SysCtlPeripheralEnable(SYSCTL_PERIPH_GPIOA);
    GPIOPinTypeGPIOOutput(GPIO_PORTA_BASE, GPIO_PIN_5);
 
    laser_init_timers();
    init_start_of_line_interrupt();
    laser_init_intensity_output();
}



void laser_enable() {
    laser_max_enabled_rotations = laser_exposure_time / laser_ms_per_rotation;
    printf("Laser enabled for %d rotations\n", laser_max_enabled_rotations);
    laser_current_rotations = 0;
    laser_enabled = 1;

}

void laser_disable() {
    laser_enabled = 0;
}

static void start_of_line_handler() {
    static volatile unsigned int timer_value_idx=0;
    static volatile unsigned int timer_prev_value;
    static volatile uint8_t compute_average=1;

    GPIOIntClear(GPIO_PORTB_BASE, GPIO_INT_PIN_5);

    volatile int tmp = TimerValueGet(TIMER3_BASE, TIMER_B);
    if (((timer_prev_value - tmp) > 5000) || ((timer_prev_value - tmp) < 0)) {
        if (laser_enabled && laser_current_rotations < laser_max_enabled_rotations) {
            laser_current_rotations++;
            TimerEnable(TIMER3_BASE, TIMER_A);

        }
        edge_count++;
    }
    if (compute_average) {
        //computes average rotation period for 10 periods
        //WARNING: it's essnetial that motor is running at full speed at this
        //time

        if (timer_prev_value > tmp) {
            //don't compute incorrect values when timer overflows
            timer_values[timer_value_idx] = timer_prev_value - tmp; 
            timer_value_idx++;
        }

        timer_prev_value = tmp;

        if (timer_value_idx>=NUM_AVERAGE_TIME) {
            int rotation_period = 0;
            for (int i=0;i<NUM_AVERAGE_TIME;i++)
                rotation_period += timer_values[i];
            rotation_period = rotation_period / NUM_AVERAGE_TIME;
            laser_setup_bit_timer(rotation_period);             
            compute_average = 0;
        }
    }
}

//generates an alternating pattern of 16mm long segments
//expects pre-allocated array
void laser_load_calibration_data() {
    for (int i=0;i<LASER_DATA_LENGTH;i++)
        ssi_data[i] = 0x00;
    
    int i=0;
    while (i < LASER_DATA_LENGTH) {
        for (int j=0;j<10;j++) {
            ssi_data[i+j] = 0xff;
        }
        i+= 20;
    }
}

void laser_set_calibration_point(int start_bit) {
    
    for (int i=0;i<LASER_DATA_LENGTH;i++)
        ssi_data[i] = 0x00;

    int byte, mask, tmp;

    for (int i=0; i < 40; i++) {
        tmp = i+start_bit;
        byte = tmp / 8;
        mask = (1 << (tmp % 8));
        ssi_data[byte] = ssi_data[byte] & mask; 
    }
}

void laser_set_exposure_time(uint16_t exposure_time) {
   laser_exposure_time = exposure_time; 
   printf("Laser exposure time set to: %d\n", laser_exposure_time);
}
void laser_set_intensity(uint8_t intensity) {
    laser_intensity = intensity;
    laser_set_intensity_output(intensity);
    printf("Laser intensity set to: %d", intensity);
}
