festlv/uvfoto/launchpad-firmware/src/gcode.c

#include <stdio.h>
#include "gcode.h"
#include "stepper.h"
#include "stellariscommon.h"
#include "laser.h"

static char command_buffer[500];

static int16_t buffer_counter=0;

void gcode_execute_command(char cmd, int command_num, char * command) {
    float tmppos;
    uint16_t tmppos_int;
    uint8_t ok = 0;

    if (cmd=='G') {
        switch (command_num) {
            case 28:
                stepper_move_to_origin();
                ok=1;
                break;
            case 1:
                if (sscanf(command, "G1 X%f", &tmppos) == 1) {
                    stepper_move_position_blocking_def(tmppos);
                    ok=1;
                }

                break;
            case 92:
                if (sscanf(command, "G92 X%f", &tmppos)==1)
                    stepper_set_position(tmppos);
                else
                    stepper_set_position(0.0);

                ok=1;
                break;

        }
    } else if (cmd=='M') {
        switch(command_num) {
            case 1:
                laser_load_calibration_data();
                ok=1;
                break;
            case 2:
                if (sscanf(command, "M2 Y%hu", &tmppos_int)==1) {
                    laser_set_calibration_point(tmppos_int);
                    ok=1;
                }
                break;
            case 3:
                break;
            case 4:
                if (sscanf(command, "M4 S%hu", &tmppos_int)==1) {
                    laser_set_intensity((uint8_t)tmppos_int);
                    ok=1;
                }
                break;
            case 5:
                if (sscanf(command, "M5 S%hu", &tmppos_int)==1) {
                    laser_set_exposure_time(tmppos_int);
                    ok=1;
                }
                break;
                
            }
    }
    if (ok)
        printf("OK\n");
    else
        printf("NOK\n");
}


static void gcode_parse_command() {
    int command_num;
    char command;
    printf("Parsing command: %s", command_buffer);
    int res = sscanf(command_buffer, "%c%d", &command, &command_num);
    if (res==2) {
        gcode_execute_command(command, command_num, command_buffer);

    } 
}

void gcode_step() {
    char tmp;
    static uint8_t ignore_rest_input = 0;

    if (CharsAvail()) {
        tmp = ReadChar();
        if (tmp==';') {
            ignore_rest_input = 1;
            command_buffer[buffer_counter]='\0';
        }

        if (!ignore_rest_input) {
            command_buffer[buffer_counter] = tmp;
            buffer_counter++;
        }        
        if (tmp=='\n') {
            if (!ignore_rest_input)
                command_buffer[buffer_counter] = '\0';
            gcode_parse_command();
            buffer_counter = 0; 
        }
    }
}
