festlv/uvfoto/(commit log)

2013-02-02 Finished carret
    [assembly.SLDASM, bar.SLDPRT, bar_mount.SLDPRT, bar_mount_switch.SLDPRT, carret.SLDPRT, carret_support.SLDPRT, distancer.SLDPRT, lm8uul.SLDPRT]
2013-02-02 Added fixing block stl
    [fixing_block.stl]
2013-02-09 Finished most of the mechanical design
    [Assem1.sldasm, Part1.sldprt, assembly.SLDASM, assembly.SLDDRW, bar_and_mounts.SLDASM, bar_and_mounts_switch.SLDASM, bar_mount.SLDPRT, bar_mount_switch.SLDPRT]
2013-04-13 Fixed homing, added schematics
    [uvfoto-avr.sch]
2013-04-28 Launchpad firmware counts edges reliably
    [LM4F120XL.cfg, assembly.SLDASM, bar_and_mounts.SLDASM, bar_and_mounts_switch.SLDASM, bar_mount.SLDPRT, bar_mount.stl, bar_mount_switch.SLDPRT, bar_mount_switch.stl]
2013-04-30 Added initial schematics in KiCad
    [laser_peripherals.sch, mcu.sch]
2013-04-30 Updated schematics
    [laser_driver.sch, laser_peripherals.sch, mcu.sch, power.sch, uvfoto-avr.sch]
2013-04-30 Finished schematics for initial prototype
    [$laser_driver.sch, laser_driver.sch, laser_peripherals.sch, mcu.sch, power.sch]
2013-05-08 Moved laser related data to separate modules
2013-05-08 Ported stepper controlling code from AVR to ARM
2013-05-08 Made a bit shorter timer cycle
    [stepper.c]
2013-05-08 Forgot to clear timer interrupt flag
2013-05-08 Using driverlib's UART getchar instead of getc
2013-05-08 Updated schematics, fixed getchar
    [laser_driver.sch, laser_peripherals.sch, mcu.sch, power.sch]
2013-05-08 Fixed an oversight- new UART function returns -1 on no data, instead of 0
    [gcode.c]
2013-05-11 Verified stepper/G-code part on hardware
2013-05-14 Cleaned up schematics
    [uvfoto-avr.sch]
2013-05-19 Updated schematics to match the code (and, reality)
    [laser_driver.sch, laser_peripherals.sch, mcu.sch, power.sch]
2013-05-30 Added more Solidworks drawings + geometric model of laserhead movement
    [assembly.SLDASM, calibration.SLDPRT, case_back_side.SLDDRW, case_back_side.SLDPRT, case_side.SLDDRW, case_side.SLDPRT, case_top.SLDPRT, cross_dowel.SLDPRT]
2013-06-02 Moving on with line drawing algorithms
    [laser_driver.sch, laser_peripherals.sch, mcu.sch, power.sch]
2013-06-04 Refactored out laser line transformation/processing
2013-06-04 Added initial calibration interface, using usb driver from Janis
2013-06-06 Added udev rule, daemonized thread which accesses serial port so it's stopped when main program exits
2013-06-28 Testing Timer based approach
2013-07-03 Started work on control software
    [gcode.g]
2013-07-04 Updated firmware to just use fixed time offset when pulsing laser
    [gcode.c, gcode.h, laser.c, laser.h, main.c]
2013-07-04 Implemented setting intensity output with PWM
